ashkorehennessy/51car/images/主循环流程图.png

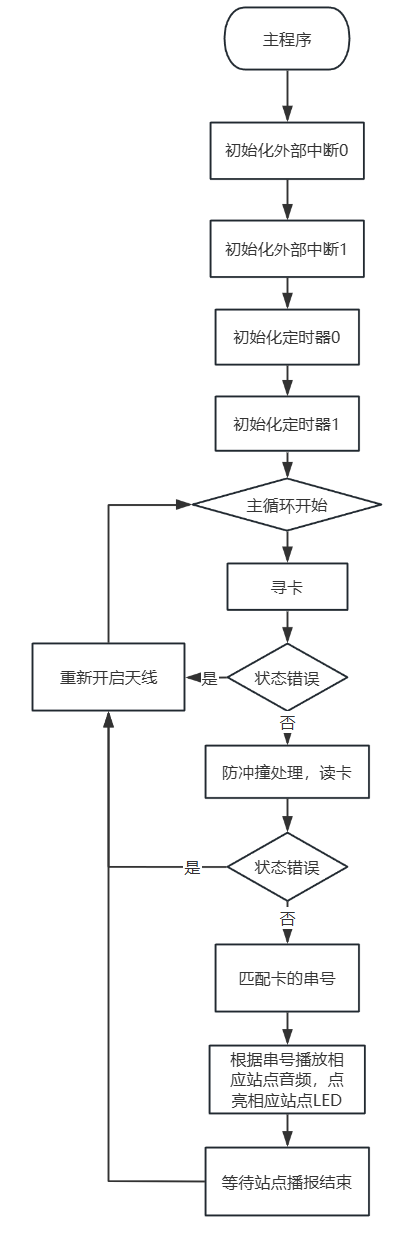
images/主循环流程图.png
