ashkorehennessy/51car/images/外部中断流程图.png

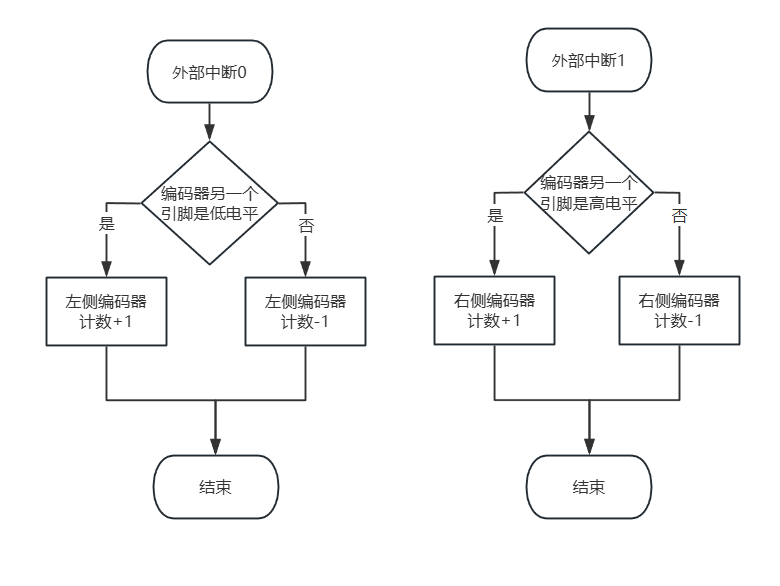
images/外部中断流程图.png
