ashkorehennessy/51car/images/定时器0流程图.png

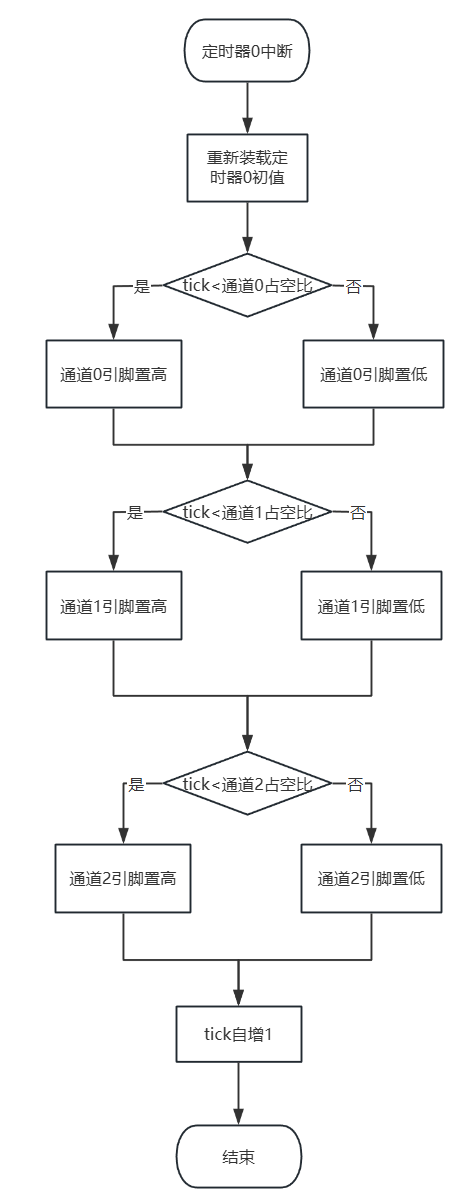
images/定时器0流程图.png
