ashkorehennessy/51car/images/定时器1流程图.png

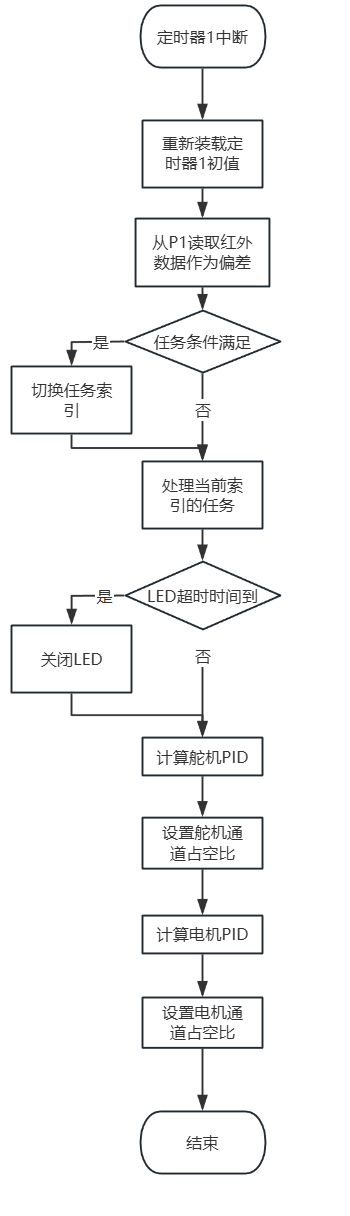
images/定时器1流程图.png
