ashkorehennessy/51car/(commit log)

2024-09-30 初始化提交
2024-10-01 读取编码器
2024-10-05 调循迹参数
2024-10-12 准备换增量PID
2024-10-12 增量PID
2024-10-15 站点停靠
2024-10-25 正式移除库
